srebosura/TalkingHAMRepeaterController/final_layout.jpeg

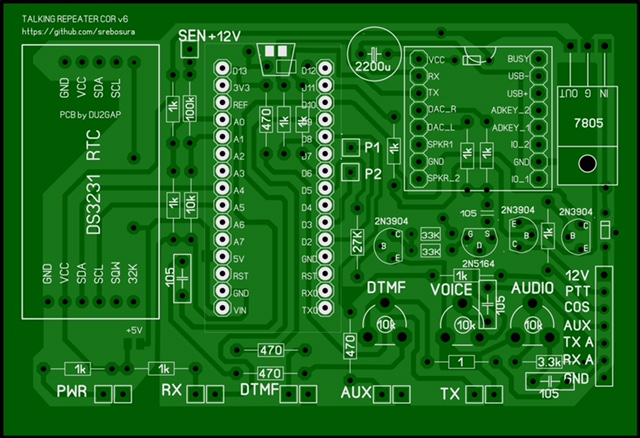
final_layout.jpeg
