srebosura/TalkingHAMRepeaterController/README.md

When using the latest Version  please add a jumper wire or 1k resistor from the busy pin of the DFplayer to D4 of the Nano.
