srebosura/TalkingHAMRepeaterController/final_layout.JPG

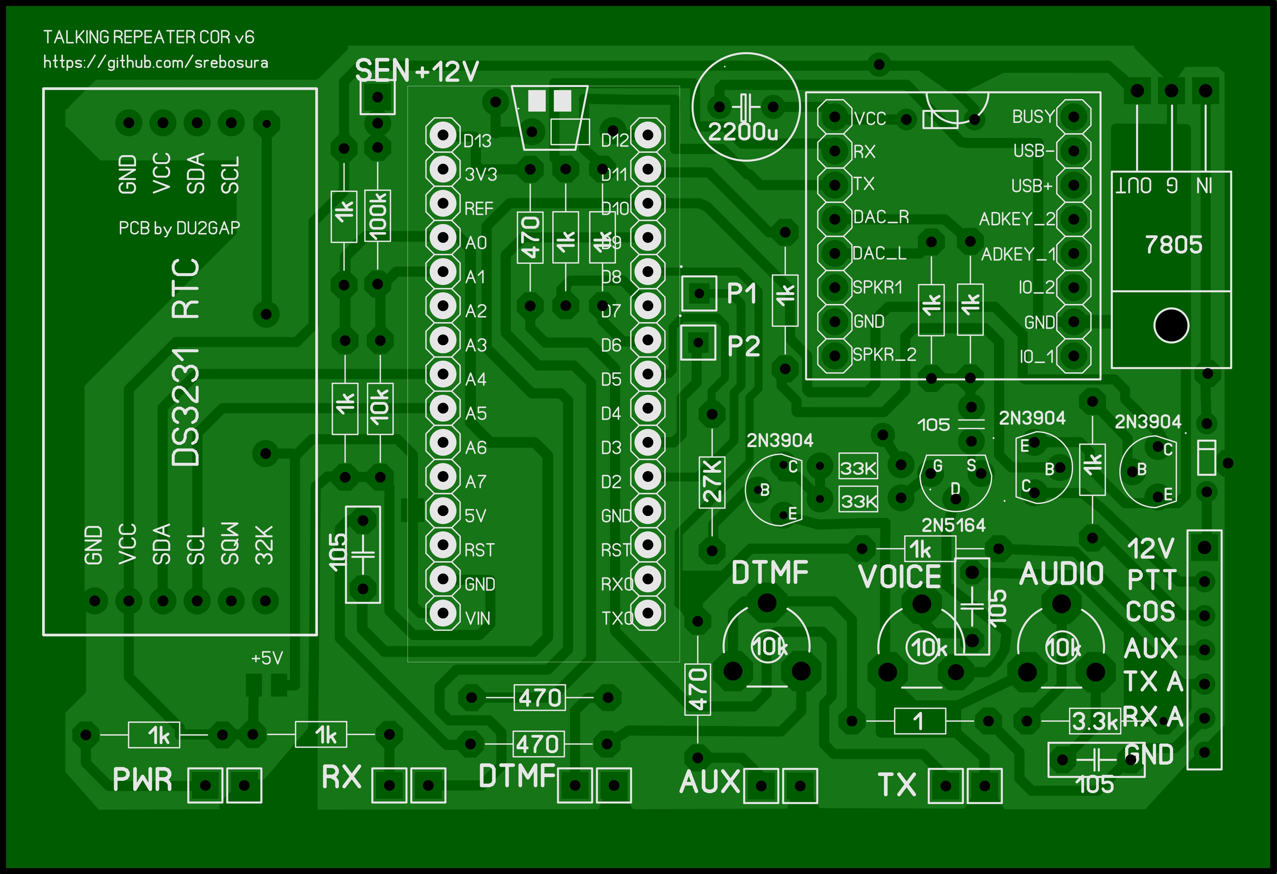
final_layout.JPG
