srebosura/TalkingHAMRepeaterController/PCB_by_RAFA_PU4XRF.png

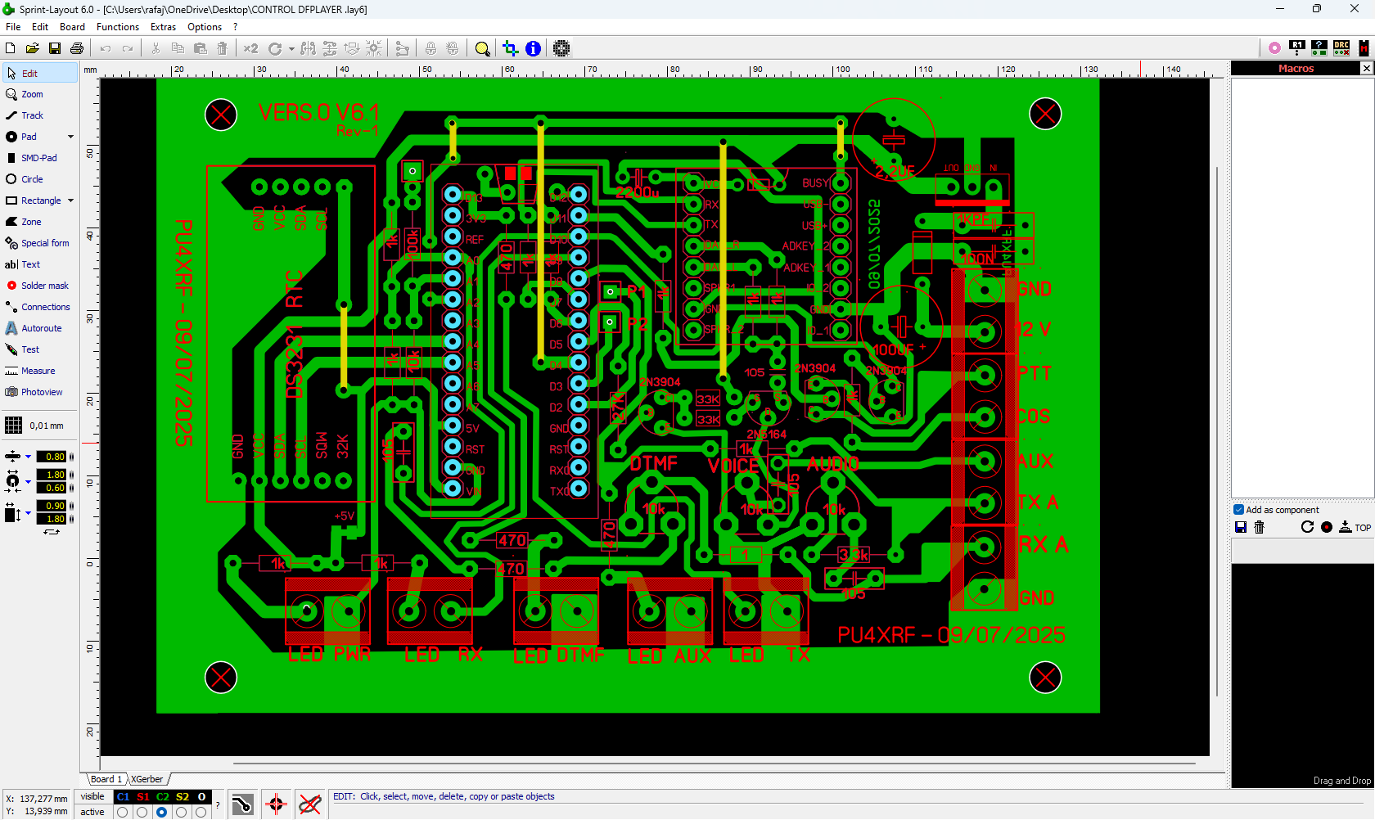
PCB_by_RAFA_PU4XRF.png
