srebosura/TalkingHAMRepeaterController/RPT_box.png

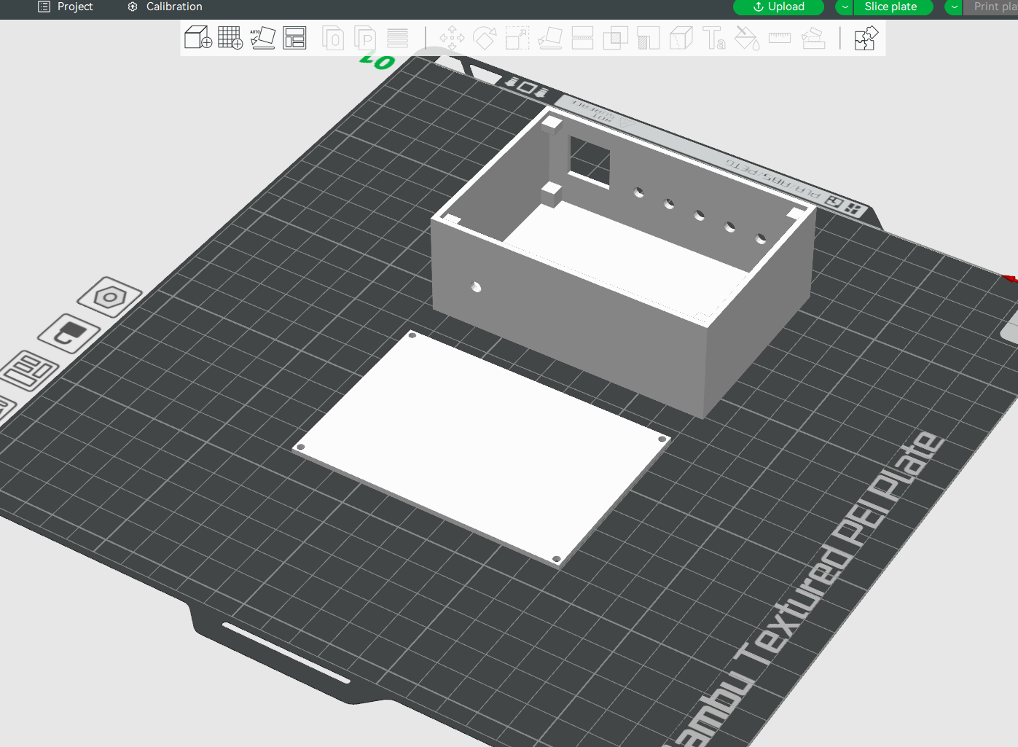
RPT_box.png
