srebosura/TalkingHAMRepeaterController/talking_repeater_COR_realtimeclock_DFplayer.jpg

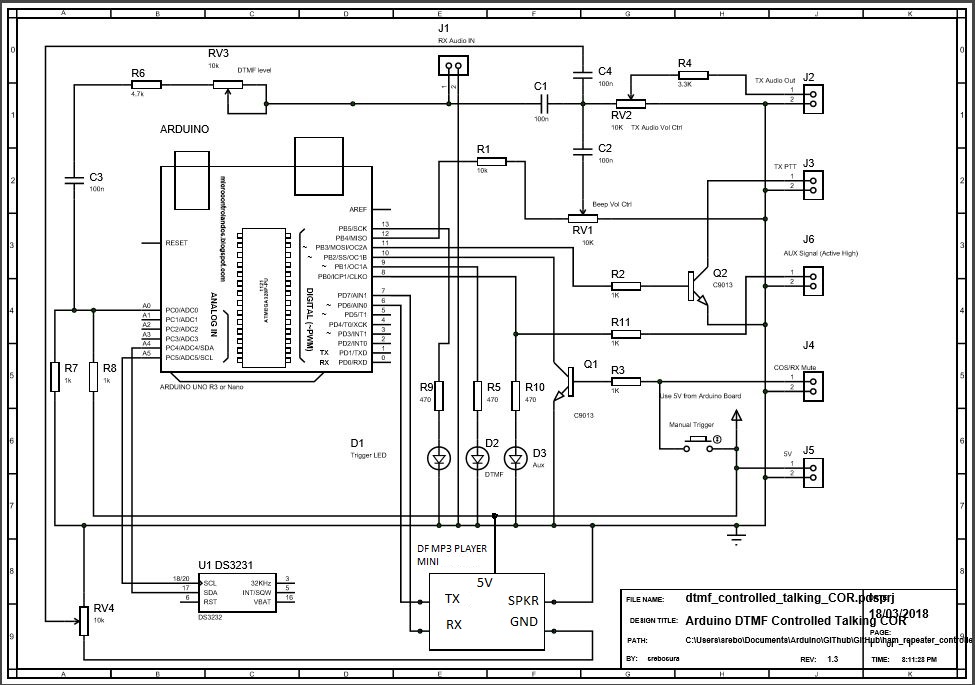
talking_repeater_COR_realtimeclock_DFplayer.jpg
