srebosura/TalkingHAMRepeaterController/RPT_box_v1 v4_FINAL.3mf

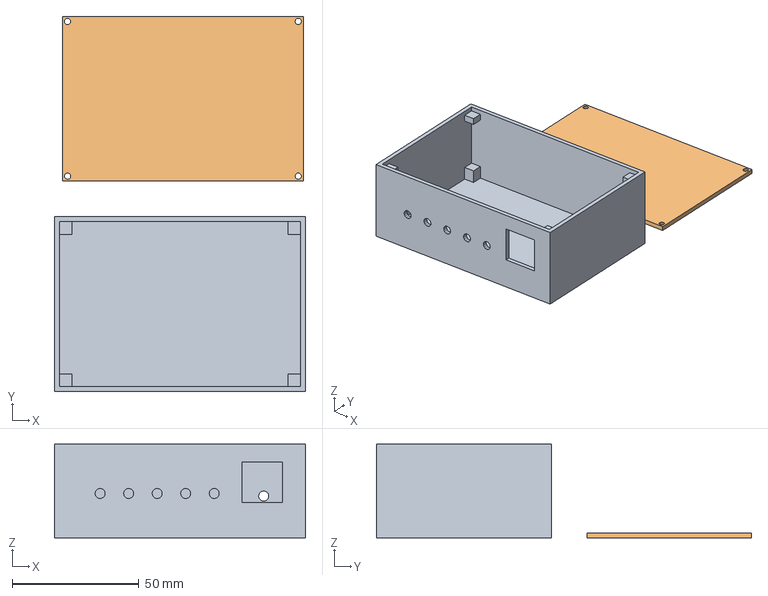
[picture p6: CAD file, 2024-10-10]
RPT_box_v1 v4_FINAL.3mf
99.0 x 148.0 x 37.0 mm
