srebosura/TalkingHAMRepeaterController/(threads)

Thread 1 (2022-12-22):

audio files??

Squire298, 2022-12-22:
would you happen to have the audio files for people to download, if they want to build this maybe it will be good to have this run out of the box?

srebosura, 2023-01-11:
[dfplayer_files.zip](https://github.com/srebosura/TalkingHAMRepeaterController/files/10388872/dfplayer_files.zip)

I have attached the sample mp3 files. The filenames of the mp3 files needs to be in the correct order as it is use in the Arduino sketch or code. I recommend to use FAT sorter when writing the files to the SD card for DF player module. You have to compress the mp3 files to lower bit rate to be able to use the internal memory of the JQ6500 mp3 module.

Closed 2023-01-11.

Thread 5 (2023-01-14):

unable to trigger more than one time

Squire298, 2023-01-14:
After keying the rx, it doesn't seem to allow you to retrigger it again unless i restart it.

srebosura, 2023-11-12:
Sorry for the very delayed response. Did it happen on the first boot and the first loading the sketch? Likely the eeprom data read by the variables were null. I think I did make fixes to this kind of situation when using a brandnew Arduino. Restarting or reset should help but you can execute the dtmf code reset to default command #1179 from on my original sketch.

Closed 2023-11-12.

Thread 6 (2023-05-09):

Small Schematic Error

k7ilo, 2023-05-09:
Hello

I noticed that the Speaker and Ground identifications on the mp3 player are backwards.  Its showing the Speaker out connected to ground and Ground is connected to the Audio out combining.

I just thought I would let you know so that it would not confuse someone who would not catch it.

Thanks and GREAT project.

K7ILO

srebosura, 2023-11-12:
It's an obvious mistake on the schematic. Thanks

Closed 2023-11-12.

Thread 7 (2024-01-28):

MP3 player

k7ilo, 2024-01-28:
Hello

I just thought I would stop by to let you know your Gnd and Speaker for the MP3 output signal are backwards.  You have the MP3 players Gnd going to the potentiometer and the speaker out going to Gnd.

Later

srebosura, 2024-10-10:
It's in drawing by mistake. Thanks

Closed 2024-10-10.

Thread 8 (2024-12-27):

Issues with ger files

Squire298, 2024-12-27:
I have submitted these to jclpbc and there's a number of errors.

Emails from jlcpcb.

 the silkscreen and text on copper layer? They are on silkscreen layer.

there is no board outline in your file ,can we add an outline as per the copper pour edge？

srebosura, 2025-05-13:
Do not include that layer or move to silkscreen. Thanks

Closed 2025-05-13.

Thread 10 (2025-05-13):

3d enclosure file  , no work

lw3dtr, 2025-05-13:
I try to download the ed project but , when i try to open it in Ultimaker Cura  give me an error:

There were no models in /home/bruno/Descargas/RPT_box_v1 v4_FINAL.3mf

I do not know what happens

Thanks for any help

srebosura, 2025-05-13:
Hi, I am using a bambu lab 3D printer. You may experience some issues which I maybe cannot help.
