srebosura/TalkingHAMRepeaterController/(list of files, drawings)

Other design files:
PCB_by_RAFA_PU4XRF .lay6
