srebosura/TalkingHAMRepeaterController/(commit log)

2019-09-14 JQ Version update
    Features:
    At the very first boot after first load of the sketch, stored EEPROM
    passcode is NULL. You have to reset the passcode to default by DTMF code
    #1179 and wait for reboot.
    The default passcode in the sketch is #2468. You can always change it
    after the reboot or when default code is set by DTMF #1179.
    #1179 – Reboot controller and reset password to default, I set it to
    #2468. This is the master code as no admin passcode required
    #3281 – Change admin passcode. New code will be stored in the EEPROM and
    require to input the current passcode first. You will require to enter
    the last 4 digit.
    Do not bother entering the # as this is always the default 1st digit of
    all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
    [talking_repeater_cor_JQplayer_Final_v3.0.ino]
2019-09-14 Sprint Layout and Gerber/Drill files
    PCB layout files by Sprint, courtesy of DU2GAP
2022-12-21 Add files via upload
    Gerber file for JQ version
2023-01-11 Sample MP3 files
    The filenames of the mp3 files needs to be in the correct order as it is use in the Arduino sketch or code. I recommend to use FAT sorter when writing the files to the SD card for DF player module. You have to compress the mp3 files to lower bit rate to be able to use the internal memory of the JQ6500 mp3 module.
2023-01-11 Schematic diagram for talking repeater with RTC and DF player
    You can use an Uno or Nano Arduino. The schematic is the basic to operate the DTMF function, RTC and the DF player module. Voltage sensing and auxiliary outputs were added later. You can follow the final PCB layout.
2024-10-10 Updated PCB layout with Arduino using 5V from in PCB source i.e. Vin no longer in use
2024-10-10 Talking RPT enclosure box for 3D printing file in 3mf
    see RPT_box.png for reference
    [RPT_box_v1 v4_FINAL.3mf]
2025-08-01 Add files via upload
    JQ6500 stock arduino library
2025-08-12 Add files via upload
    PCB contributed by Rafael PU4XRF
    [PCB_by_RAFA_PU4XRF .lay6]
